d00p44/freqcount/freqcount_v2.0/readme.txt

v1.0
-Cs am Quarz falsch angebunden 
-kein ISP-Stecker
-----------------------------------------------------
v1.1
-Letzte Teilerstufe ergänzen 7->15 / 13->Dip-Schalter (1Hz Pulse)
-Status LED für Betriebs und Gatezustand ergänzen

Planung v2.0: -zusätzlicher 32-Bit-Zähler für Reziprokzählverfahren
	 		 -Gateöffner für beide Zähler
			 -ESP kompatibel mit MCP23017 (LP kompatibel mit ESPboy)
			 -Koax-SV für Messsignal
			 - Quarz-Adapter oder Abracon für Referenz

evtl. Netzteil und Batteriehalterung ergänzen
