d00p44/freqcount/freqcount_v2.0/out/freqcount1.1.pdf

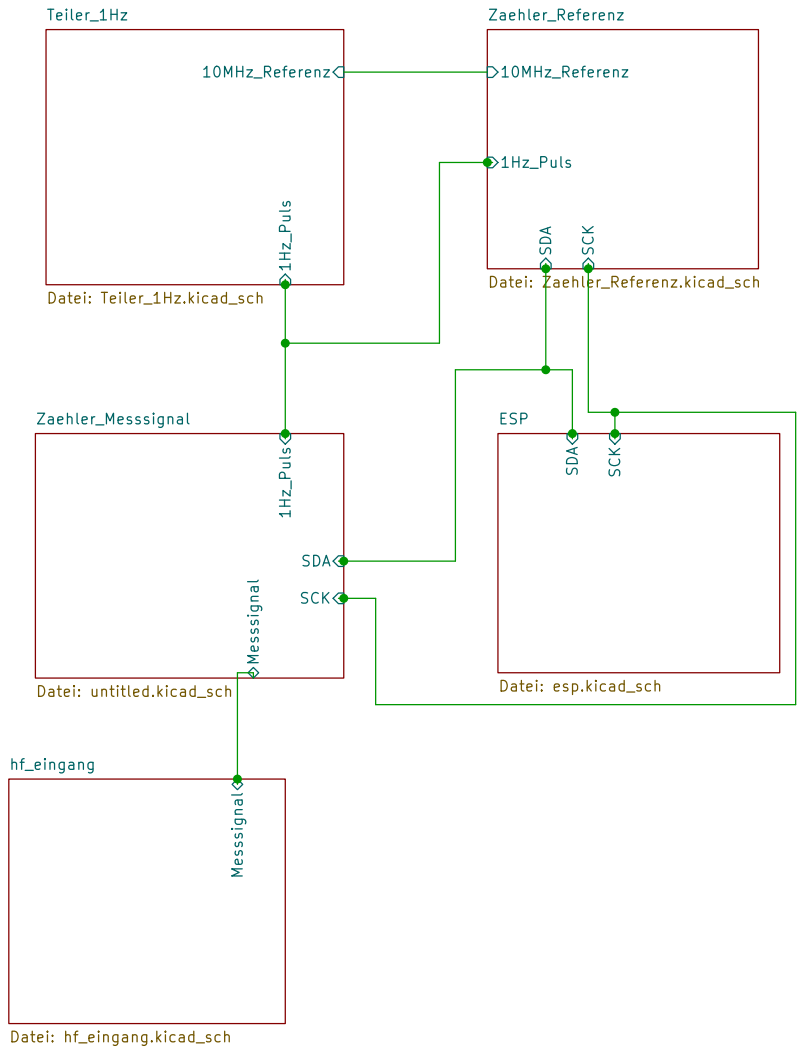
[picture p1: page 1]

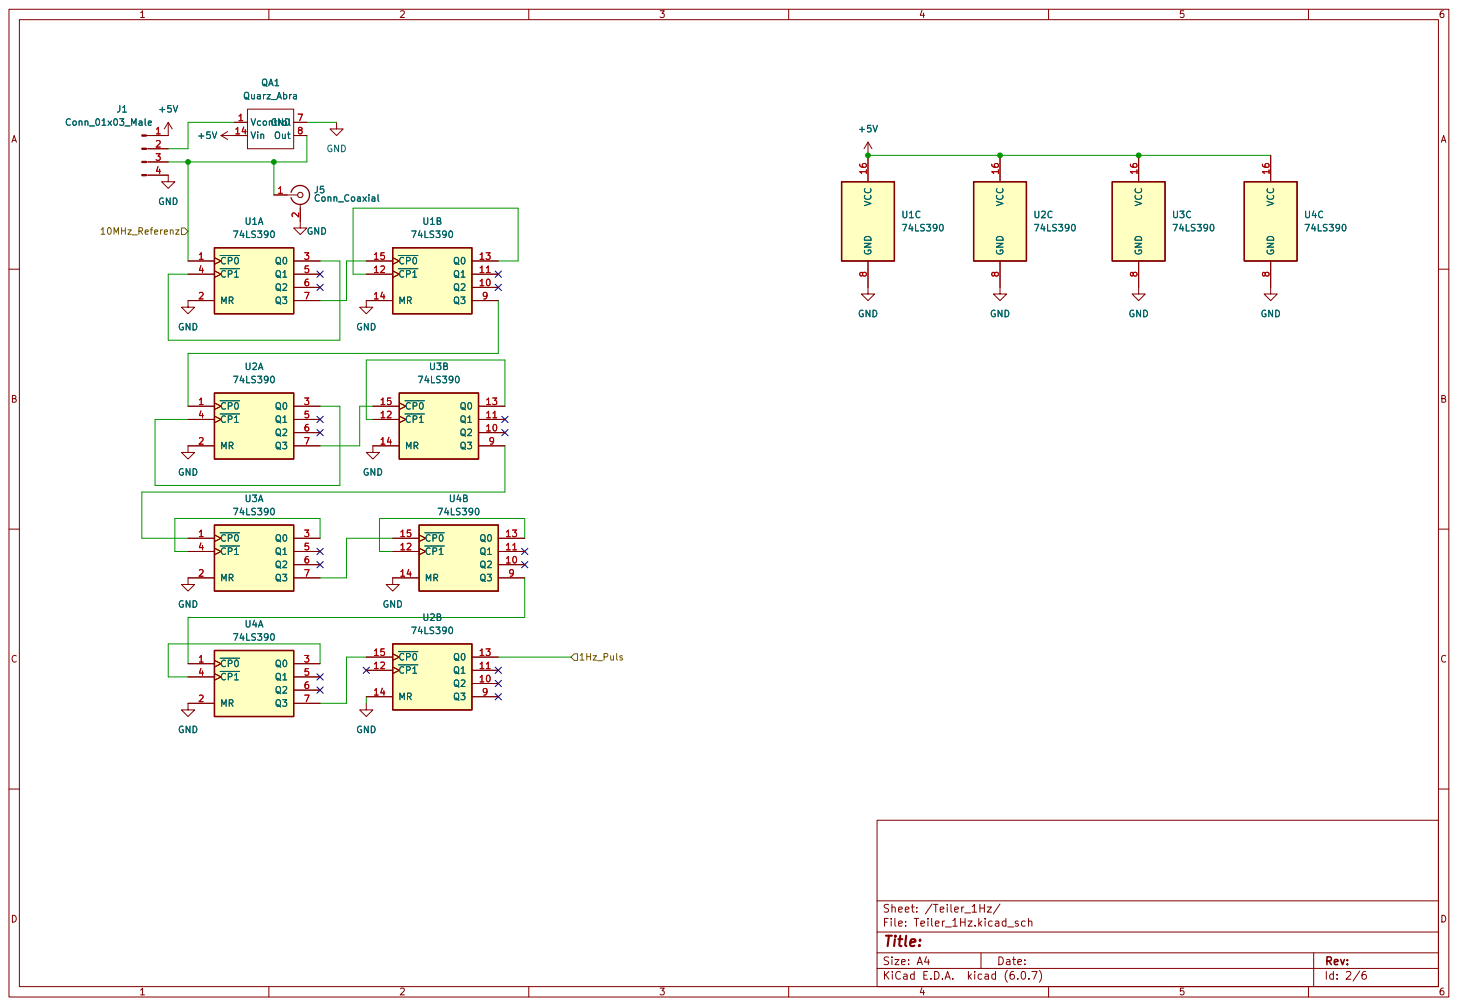
[picture p2: page 2]

2 +5V QA1 Quarz_Abra Vcontrol 1 Vin 14 GND 7 Out 8 U2A

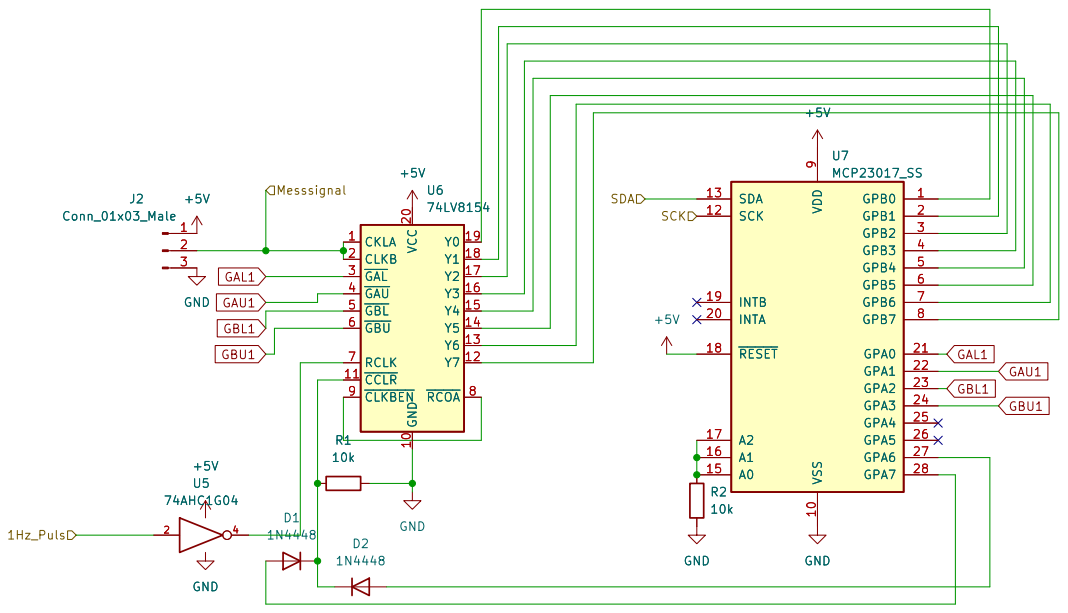
[picture p3: page 3]

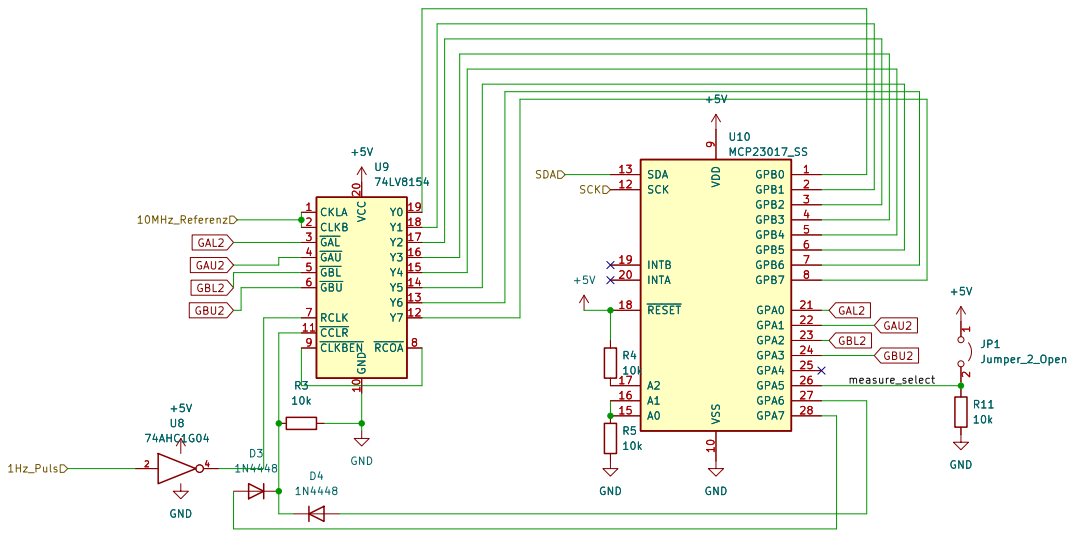
[picture p4: page 4]

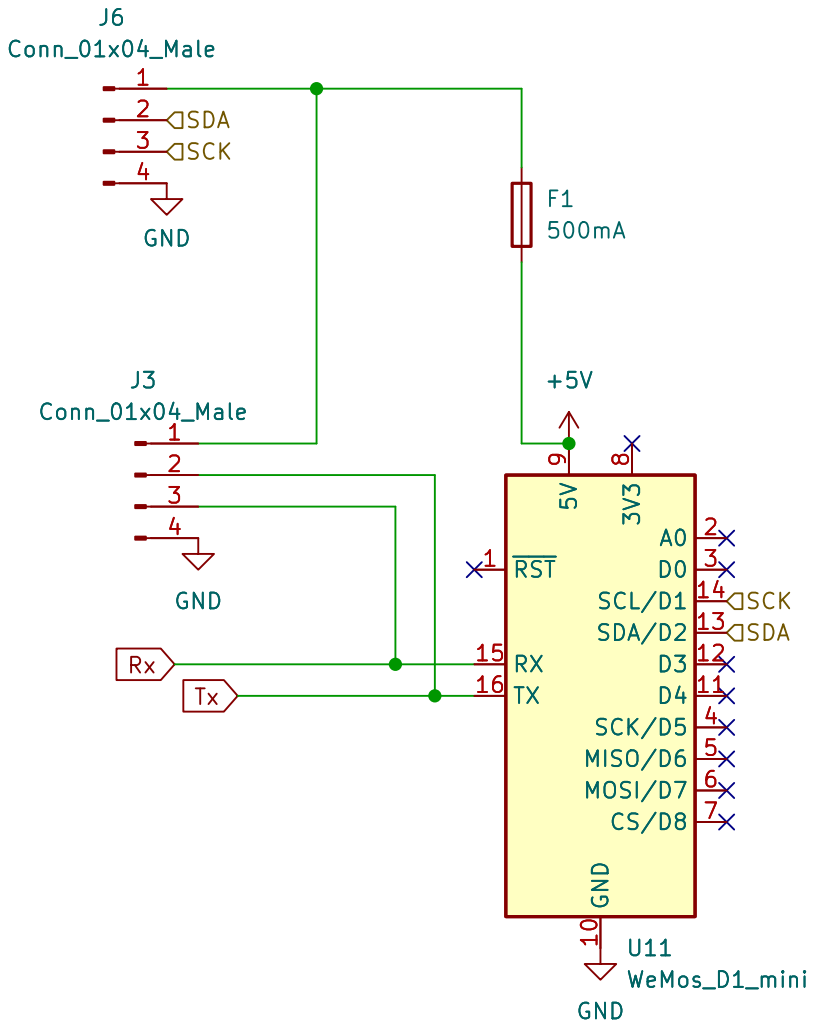
[picture p5: page 5]

File: esp.kicad_sch Sheet: /ESP/

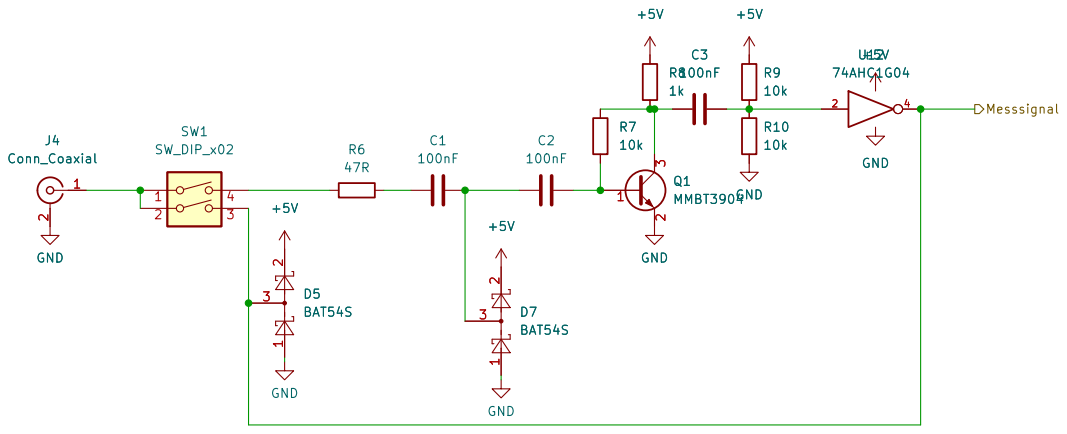
[picture p6: page 6]
