d00p44/freqcount/freqcount_v2.0/out/best.pdf

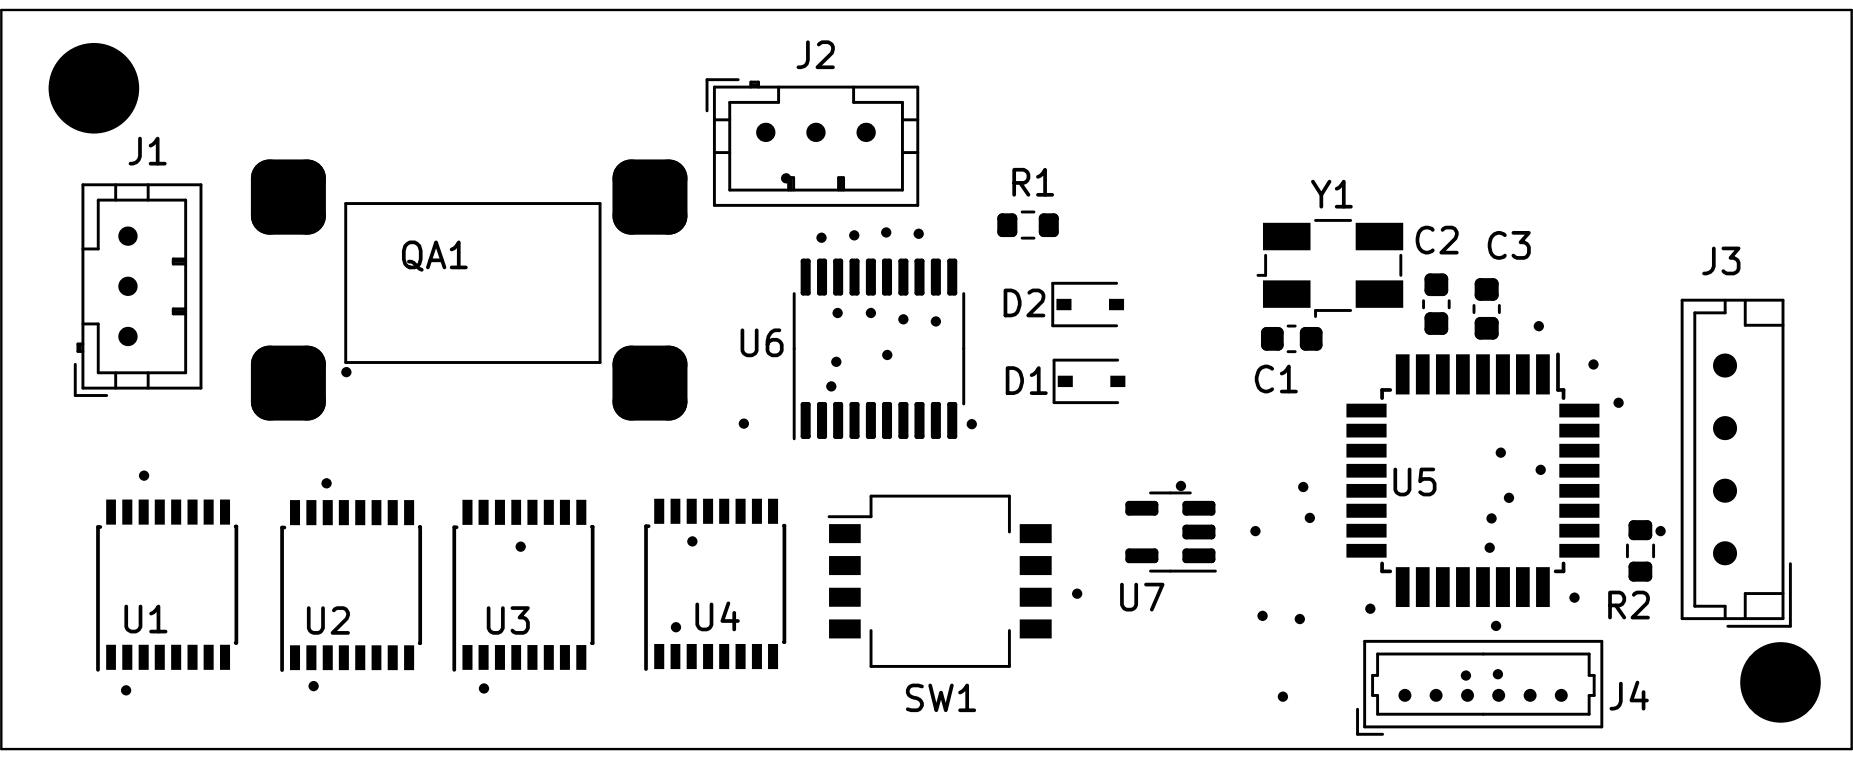
[picture p7: page 1]
