d00p44/freqcount/freqcount_v1.1/out/freqcount1.1.pdf

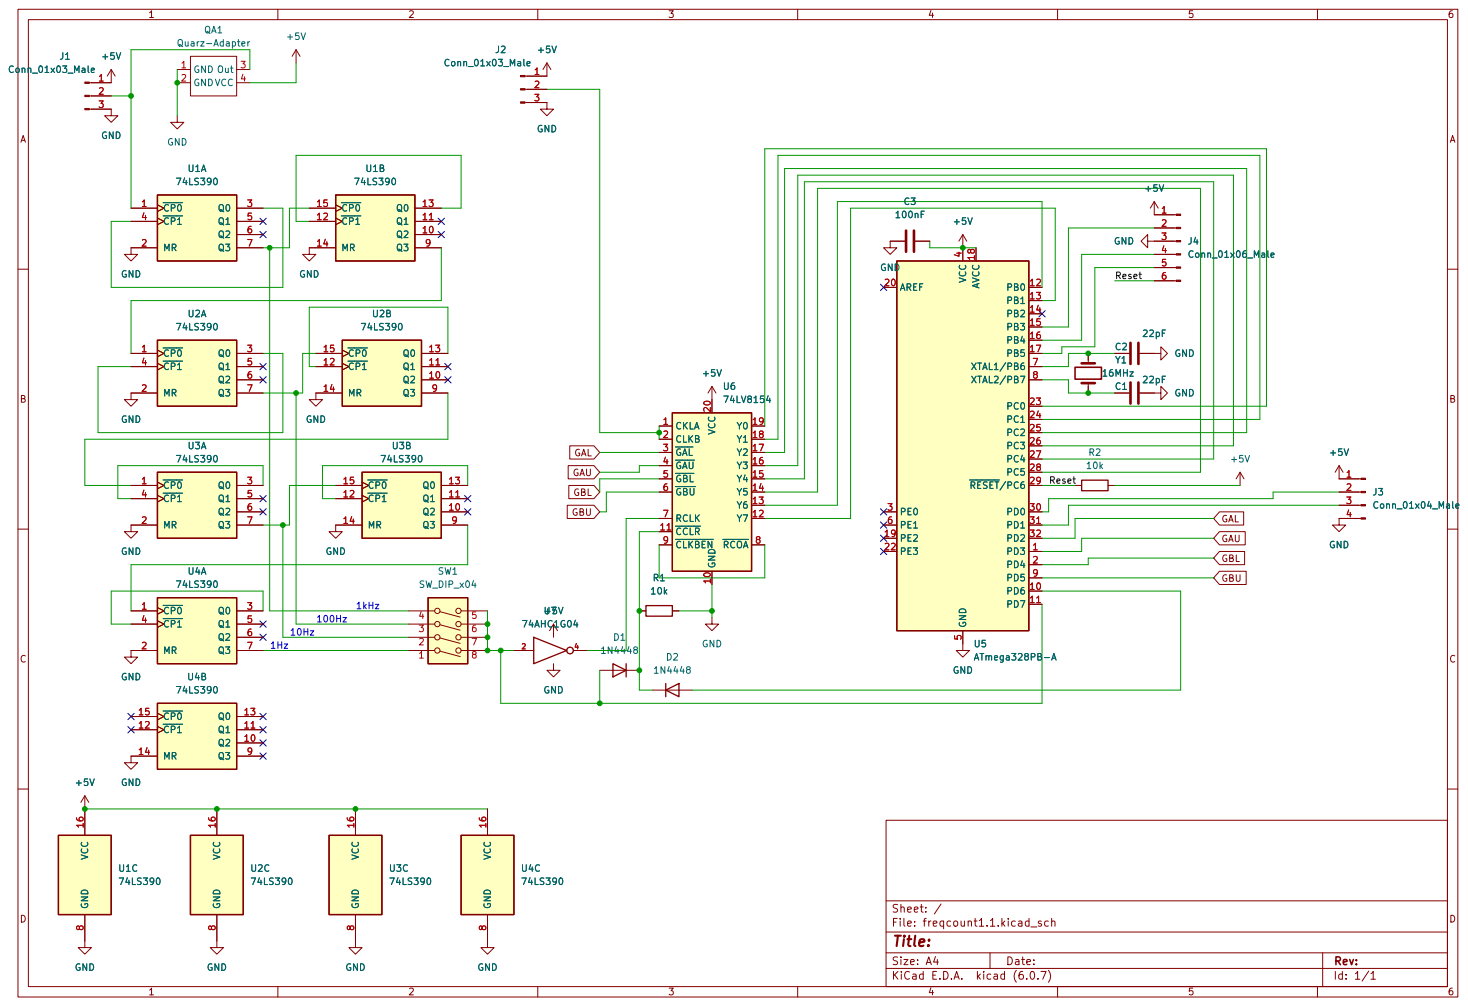
[picture p8: page 1]
