d00p44/freqcount/freqcount_v2.0/hf_eingang.asc

A1: inv; td=10n Vhigh=3.3
C1: cap; 100nF
C2: cap; 100nF
C3: cap; 100nF
D1: zener
D2: zener
Q1: npn; DI_MMBT3904
R1: res; 47
R2: res; 10k
R3: res; 1k
R4: res; 10k
R5: res; 10k
V1: voltage; 5
V2: voltage; SINE(0 0.8 4Meg)
Named nets: 0, Vcc, Out
.tran 1u
