d00p44/freqcount/freqcount_v2.0/freqcount1.1.kicad_pcb

## KiCad design freqcount_v2.0/freqcount1.1.kicad_pcb (2023-10-13)

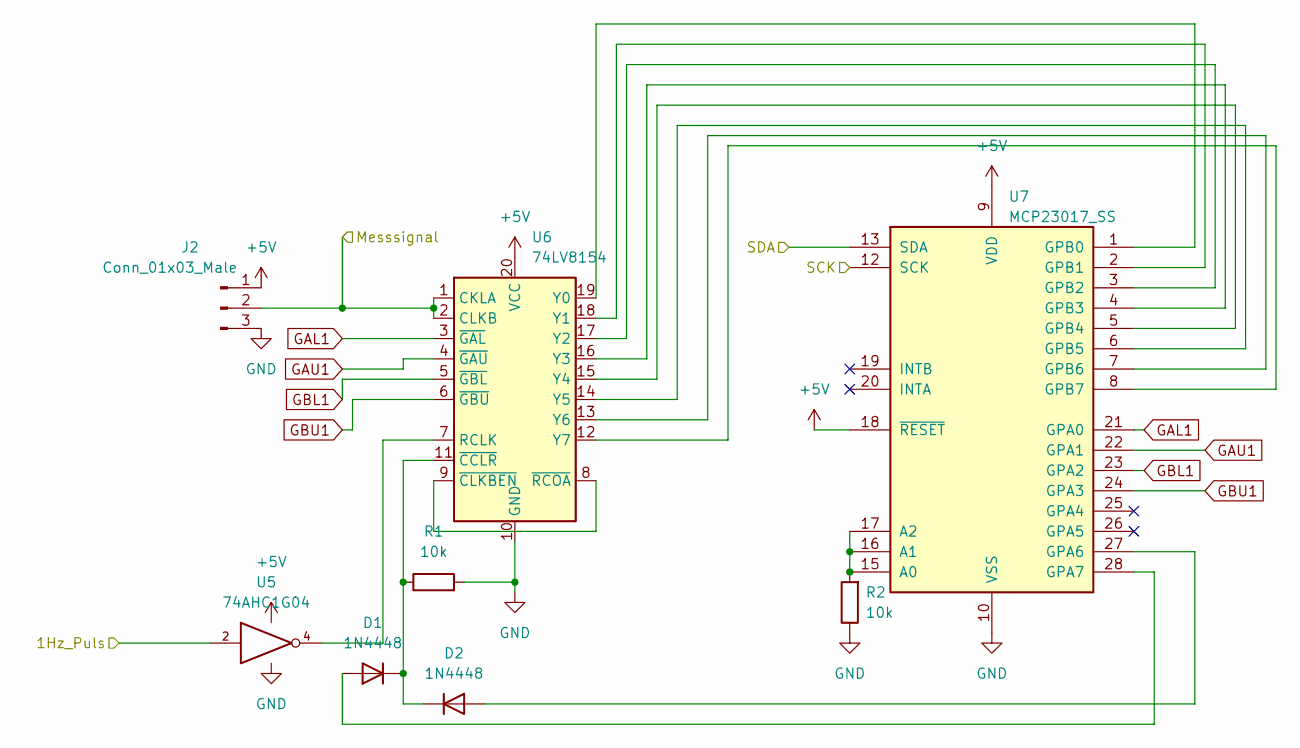
[picture p9: schematic untitled.kicad_sch]

Parts:
D1, D2: 1N4448; D_SOD-323
J2: Conn_01x03_Male; JST_PH_B3B-PH-K_1x03_P2.00mm_Vertical
R1, R2: 10k; R_0603_1608Metric
U5: 74AHC1G04; SOT-23-5
U6: 74LV8154; TSSOP-20_4.4x6.5mm_P0.65mm
U7: MCP23017_SS; SSOP-28_5.3x10.2mm_P0.65mm

Connections:
+5V: J2.1, U5.5 (VCC), U6.20 (VCC), U7.9 (VDD), U7.18 (~RESET); also elsewhere on the board
/ESP/SCK: U7.12 (SCK); also elsewhere on the board
/ESP/SDA: U7.13 (SDA); also elsewhere on the board
/Teiler_1Hz/1Hz_Puls: U5.2; also elsewhere on the board
/Zaehler_Messsignal/Messsignal: J2.2, U6.1 (CKLA), U6.2 (CLKB); also elsewhere on the board
GAL1: U6.3 (~GAL), U7.21 (GPA0)
GAU1: U6.4 (~GAU), U7.22 (GPA1)
GBL1: U6.5 (~GBL), U7.23 (GPA2)
GBU1: U6.6 (~GBU), U7.24 (GPA3)
GND: J2.3, R1.2, R2.1, U5.3 (GND), U6.10 (GND), U7.10 (VSS); also elsewhere on the board
unnamed: D1.1 (K), D2.1 (K), R1.1, U6.11 (~CCLR)
unnamed: D1.2 (A), U7.28 (GPA7)
unnamed: D2.2 (A), U7.27 (GPA6)
unnamed: R2.2, U7.15 (A0), U7.16 (A1), U7.17 (A2)
unnamed: U5.4, U6.7 (RCLK)
unnamed: U6.8 (~RCOA), U6.9 (~CLKBEN)
unnamed: U6.12 (Y7), U7.8 (GPB7)
unnamed: U6.13 (Y6), U7.7 (GPB6)
unnamed: U6.14 (Y5), U7.6 (GPB5)
unnamed: U6.15 (Y4), U7.5 (GPB4)
unnamed: U6.16 (Y3), U7.4 (GPB3)
unnamed: U6.17 (Y2), U7.3 (GPB2)
unnamed: U6.18 (Y1), U7.2 (GPB1)
unnamed: U6.19 (Y0), U7.1 (GPB0)

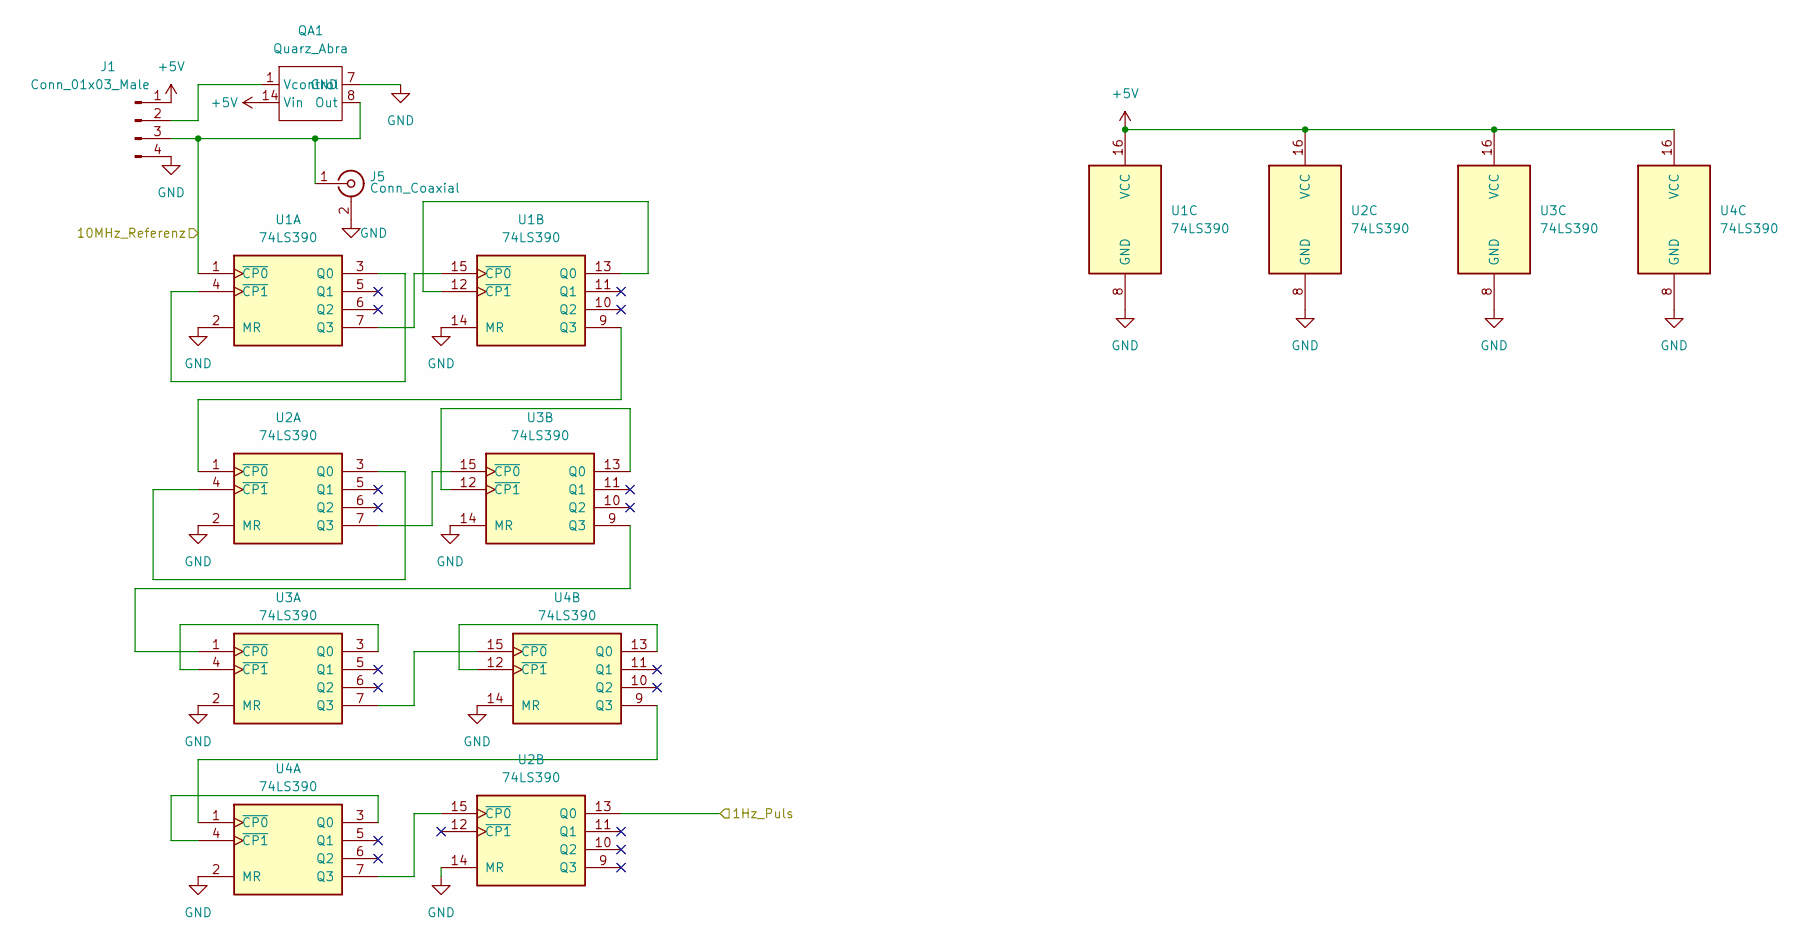
[picture p10: schematic Teiler_1Hz.kicad_sch]

Parts:
J1: Conn_01x03_Male; JST_PH_B4B-PH-K_1x04_P2.00mm_Vertical
J5: Conn_Coaxial; SMA_Amphenol_901-144_Vertical
QA1: Quarz_Abra; Quarz-Abra
U1, U2, U3, U4: 74LS390; SSOP-16_4.4x5.2mm_P0.65mm

Connections:
+5V: J1.1, QA1.14 (Vin), U1.16 (VCC), U2.16 (VCC), U3.16 (VCC), U4.16 (VCC); also elsewhere on the board
/Teiler_1Hz/1Hz_Puls: U2.13 (Q0); also elsewhere on the board
/Teiler_1Hz/10MHz_Referenz: J1.3, J5.1 (In), QA1.8 (Out), U1.1 (~CP0); also elsewhere on the board
GND: J1.4, J5.2 (Ext), QA1.7 (GND), U1.2 (MR), U1.8 (GND), U1.14 (MR), U2.2 (MR), U2.8 (GND), U2.14 (MR), U3.2 (MR), U3.8 (GND), U3.14 (MR), U4.2 (MR), U4.8 (GND), U4.14 (MR); also elsewhere on the board
unnamed: J1.2, QA1.1 (Vcontrol)
unnamed: U1.3 (Q0), U1.4 (~CP1)
unnamed: U1.9 (Q3), U2.1 (~CP0)
unnamed: U1.12 (~CP1), U1.13 (Q0)
unnamed: U1.7 (Q3), U1.15 (~CP0)
unnamed: U2.3 (Q0), U2.4 (~CP1)
unnamed: U2.7 (Q3), U3.15 (~CP0)
unnamed: U2.15 (~CP0), U4.7 (Q3)
unnamed: U3.1 (~CP0), U3.9 (Q3)
unnamed: U3.3 (Q0), U3.4 (~CP1)
unnamed: U3.7 (Q3), U4.15 (~CP0)
unnamed: U3.12 (~CP1), U3.13 (Q0)
unnamed: U4.1 (~CP0), U4.9 (Q3)
unnamed: U4.3 (Q0), U4.4 (~CP1)
unnamed: U4.12 (~CP1), U4.13 (Q0)

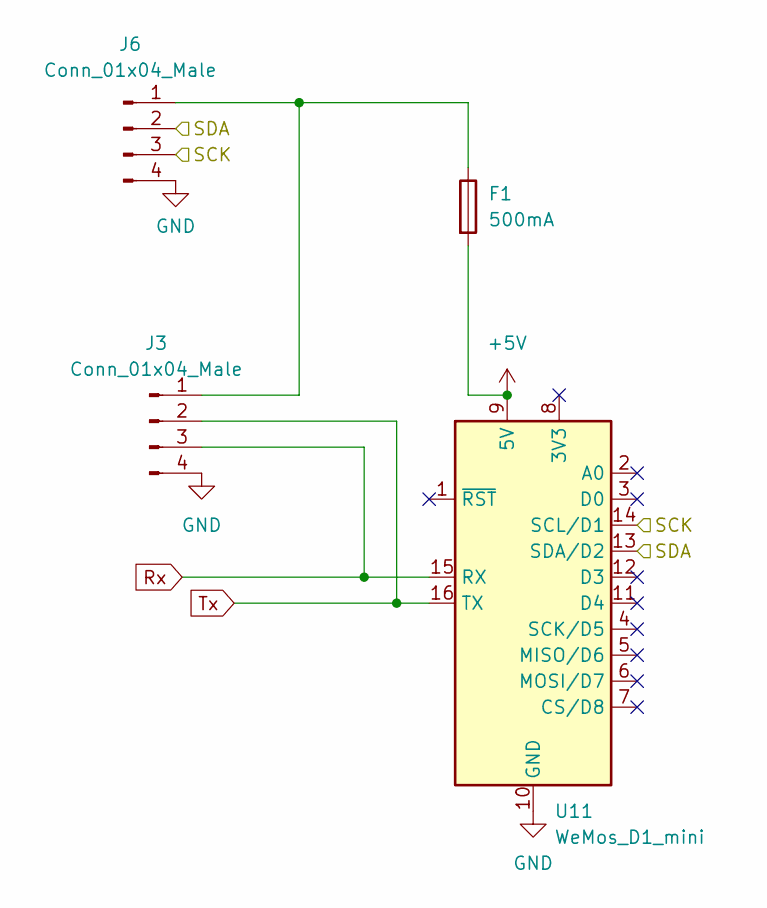
[picture p11: schematic esp.kicad_sch]

Parts:
F1: 500mA; Fuseholder_TR5_Littelfuse_No560_No460
J3, J6: Conn_01x04_Male; JST_PH_B4B-PH-K_1x04_P2.00mm_Vertical
U11: WeMos_D1_mini; WEMOS_D1_mini_light

Connections:
+5V: F1.2, U11.9 (5V); also elsewhere on the board
/ESP/SCK: J6.3, U11.14 (SCL/D1); also elsewhere on the board
/ESP/SDA: J6.2, U11.13 (SDA/D2); also elsewhere on the board
GND: J3.4, J6.4, U11.10 (GND); also elsewhere on the board
unnamed: F1.1, J3.1, J6.1
Rx: J3.3, U11.15 (RX)
Tx: J3.2, U11.16 (TX)

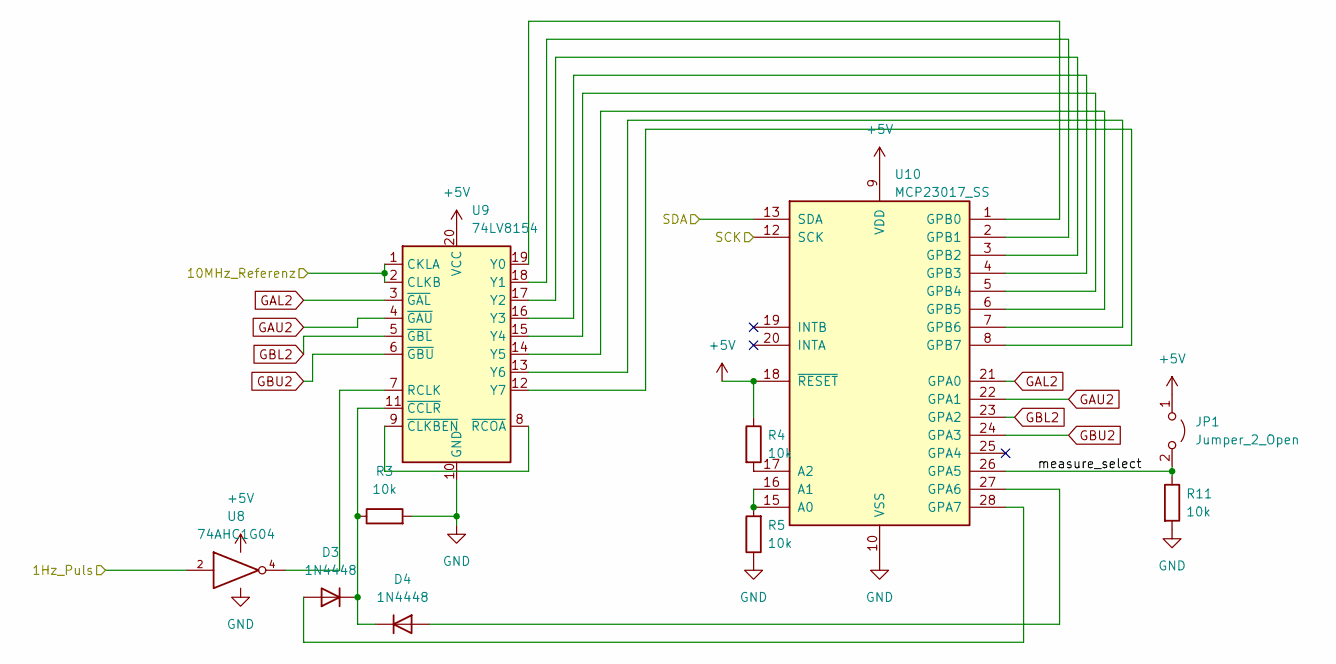
[picture p12: schematic Zaehler_Referenz.kicad_sch]

Parts:
D3, D4: 1N4448; D_SOD-323
JP1: Jumper_2_Open; PinHeader_1x02_P2.54mm_Vertical
R3, R4, R5, R11: 10k; R_0603_1608Metric
U8: 74AHC1G04; SOT-23-5
U9: 74LV8154; TSSOP-20_4.4x6.5mm_P0.65mm
U10: MCP23017_SS; SSOP-28_5.3x10.2mm_P0.65mm

Connections:
+5V: JP1.1 (A), R4.1, U8.5 (VCC), U9.20 (VCC), U10.9 (VDD), U10.18 (~RESET); also elsewhere on the board
/ESP/SCK: U10.12 (SCK); also elsewhere on the board
/ESP/SDA: U10.13 (SDA); also elsewhere on the board
/Teiler_1Hz/1Hz_Puls: U8.2; also elsewhere on the board
/Teiler_1Hz/10MHz_Referenz: U9.1 (CKLA), U9.2 (CLKB); also elsewhere on the board
/Zaehler_Referenz/measure_select: JP1.2 (B), R11.1, U10.26 (GPA5)
GAL2: U9.3 (~GAL), U10.21 (GPA0)
GAU2: U9.4 (~GAU), U10.22 (GPA1)
GBL2: U9.5 (~GBL), U10.23 (GPA2)
GBU2: U9.6 (~GBU), U10.24 (GPA3)
GND: R3.2, R5.1, R11.2, U8.3 (GND), U9.10 (GND), U10.10 (VSS); also elsewhere on the board
unnamed: D3.1 (K), D4.1 (K), R3.1, U9.11 (~CCLR)
unnamed: D3.2 (A), U10.28 (GPA7)
unnamed: D4.2 (A), U10.27 (GPA6)
unnamed: R4.2, U10.17 (A2)
unnamed: R5.2, U10.15 (A0), U10.16 (A1)
unnamed: U8.4, U9.7 (RCLK)
unnamed: U9.8 (~RCOA), U9.9 (~CLKBEN)
unnamed: U9.19 (Y0), U10.1 (GPB0)
unnamed: U9.18 (Y1), U10.2 (GPB1)
unnamed: U9.17 (Y2), U10.3 (GPB2)
unnamed: U9.16 (Y3), U10.4 (GPB3)
unnamed: U9.15 (Y4), U10.5 (GPB4)
unnamed: U9.14 (Y5), U10.6 (GPB5)
unnamed: U9.13 (Y6), U10.7 (GPB6)
unnamed: U9.12 (Y7), U10.8 (GPB7)

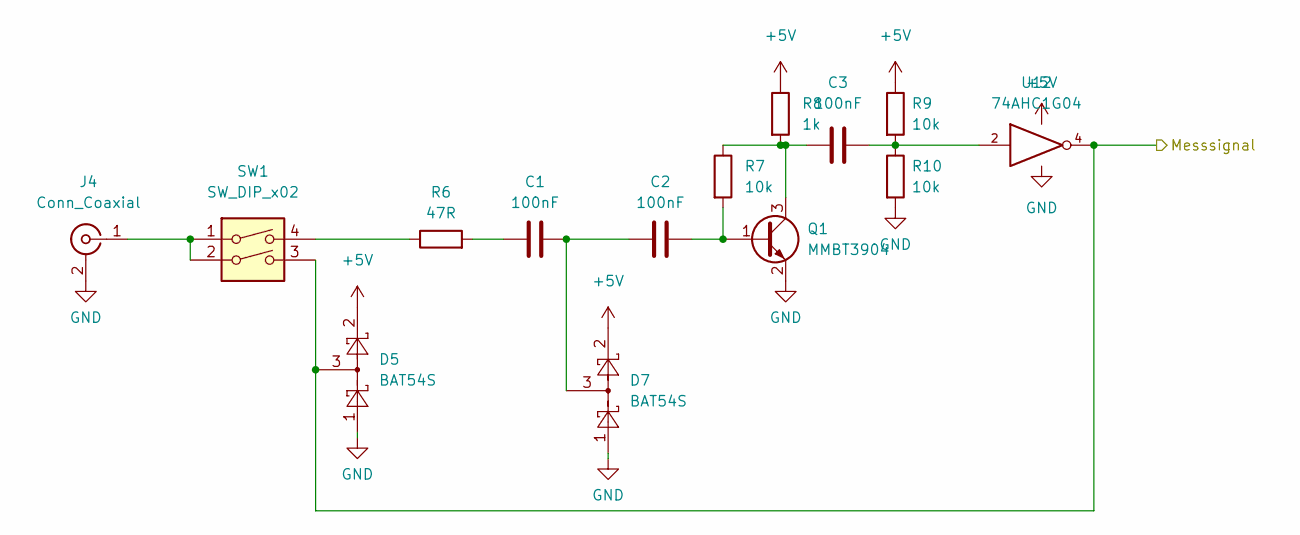
[picture p13: schematic hf_eingang.kicad_sch]

Parts:
C1, C2, C3: 100nF; C_0603_1608Metric
D5, D7: BAT54S; SOT-23
J4: Conn_Coaxial; SMA_Amphenol_901-144_Vertical
Q1: MMBT3904; SOT-23
R6: 47R; R_0603_1608Metric
R7, R9, R10: 10k; R_0603_1608Metric
R8: 1k; R_0603_1608Metric
SW1: SW_DIP_x02; DIP-4_W8.89mm_SMDSocket_LongPads
U12: 74AHC1G04; SOT-23-5

Connections:
+5V: D5.2, D7.2, R8.1, R9.1, U12.5 (VCC); also elsewhere on the board
/Zaehler_Messsignal/Messsignal: D5.3, SW1.3, U12.4; also elsewhere on the board
GND: D5.1, D7.1, J4.2 (Ext), Q1.2 (E), R10.2, U12.3 (GND); also elsewhere on the board
unnamed: C1.1, R6.2
unnamed: C1.2, C2.1, D7.3
unnamed: C2.2, Q1.1 (B), R7.2
unnamed: C3.1, Q1.3 (C), R7.1, R8.2
unnamed: C3.2, R9.2, R10.1, U12.2
unnamed: J4.1 (In), SW1.1, SW1.2
unnamed: R6.1, SW1.4

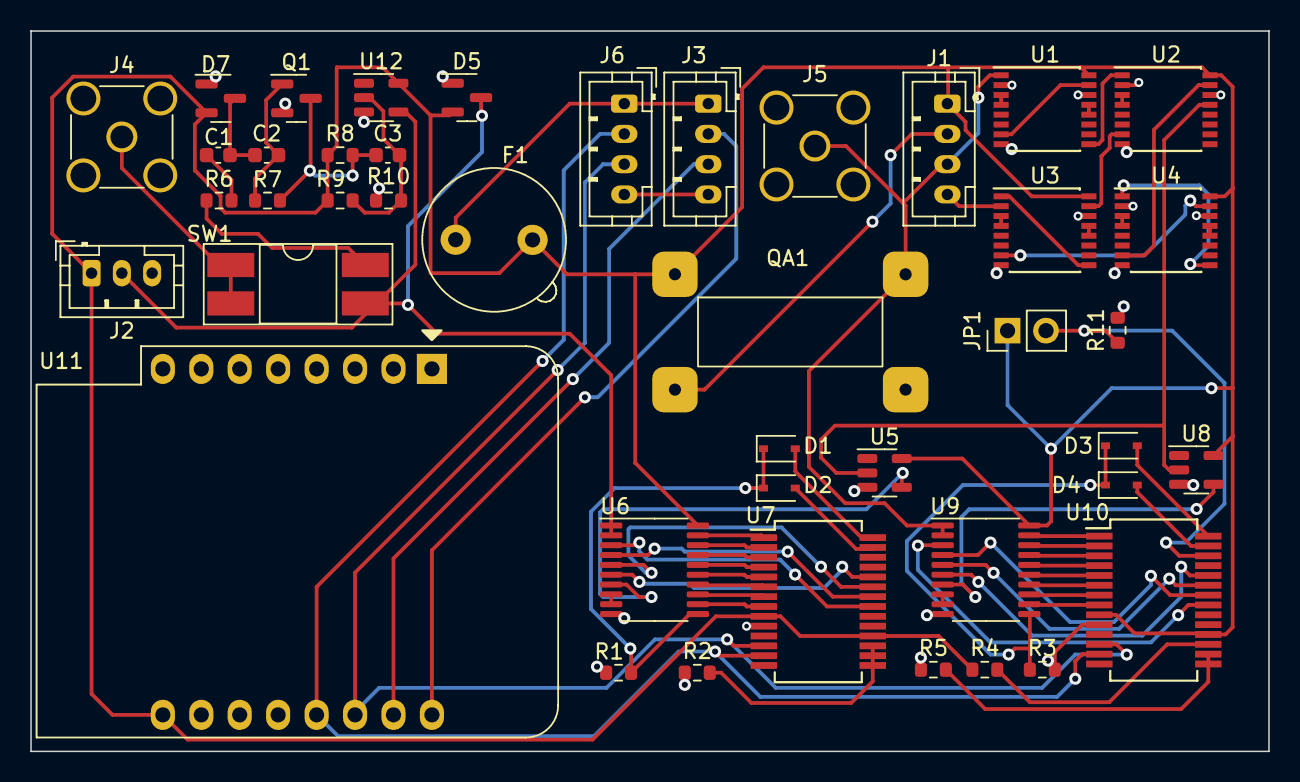
[picture p14: board freqcount1.1.kicad_pcb from above]

Board: 2 copper layers, 81.8 x 47.6 mm, 43 parts (0 on the bottom side), 70 nets.
