d00p44/freqcount/freqcount_v1/freqcount.kicad_pcb

## KiCad design freqcount_v1/freqcount.kicad_pcb (2023-06-28, an earlier design)

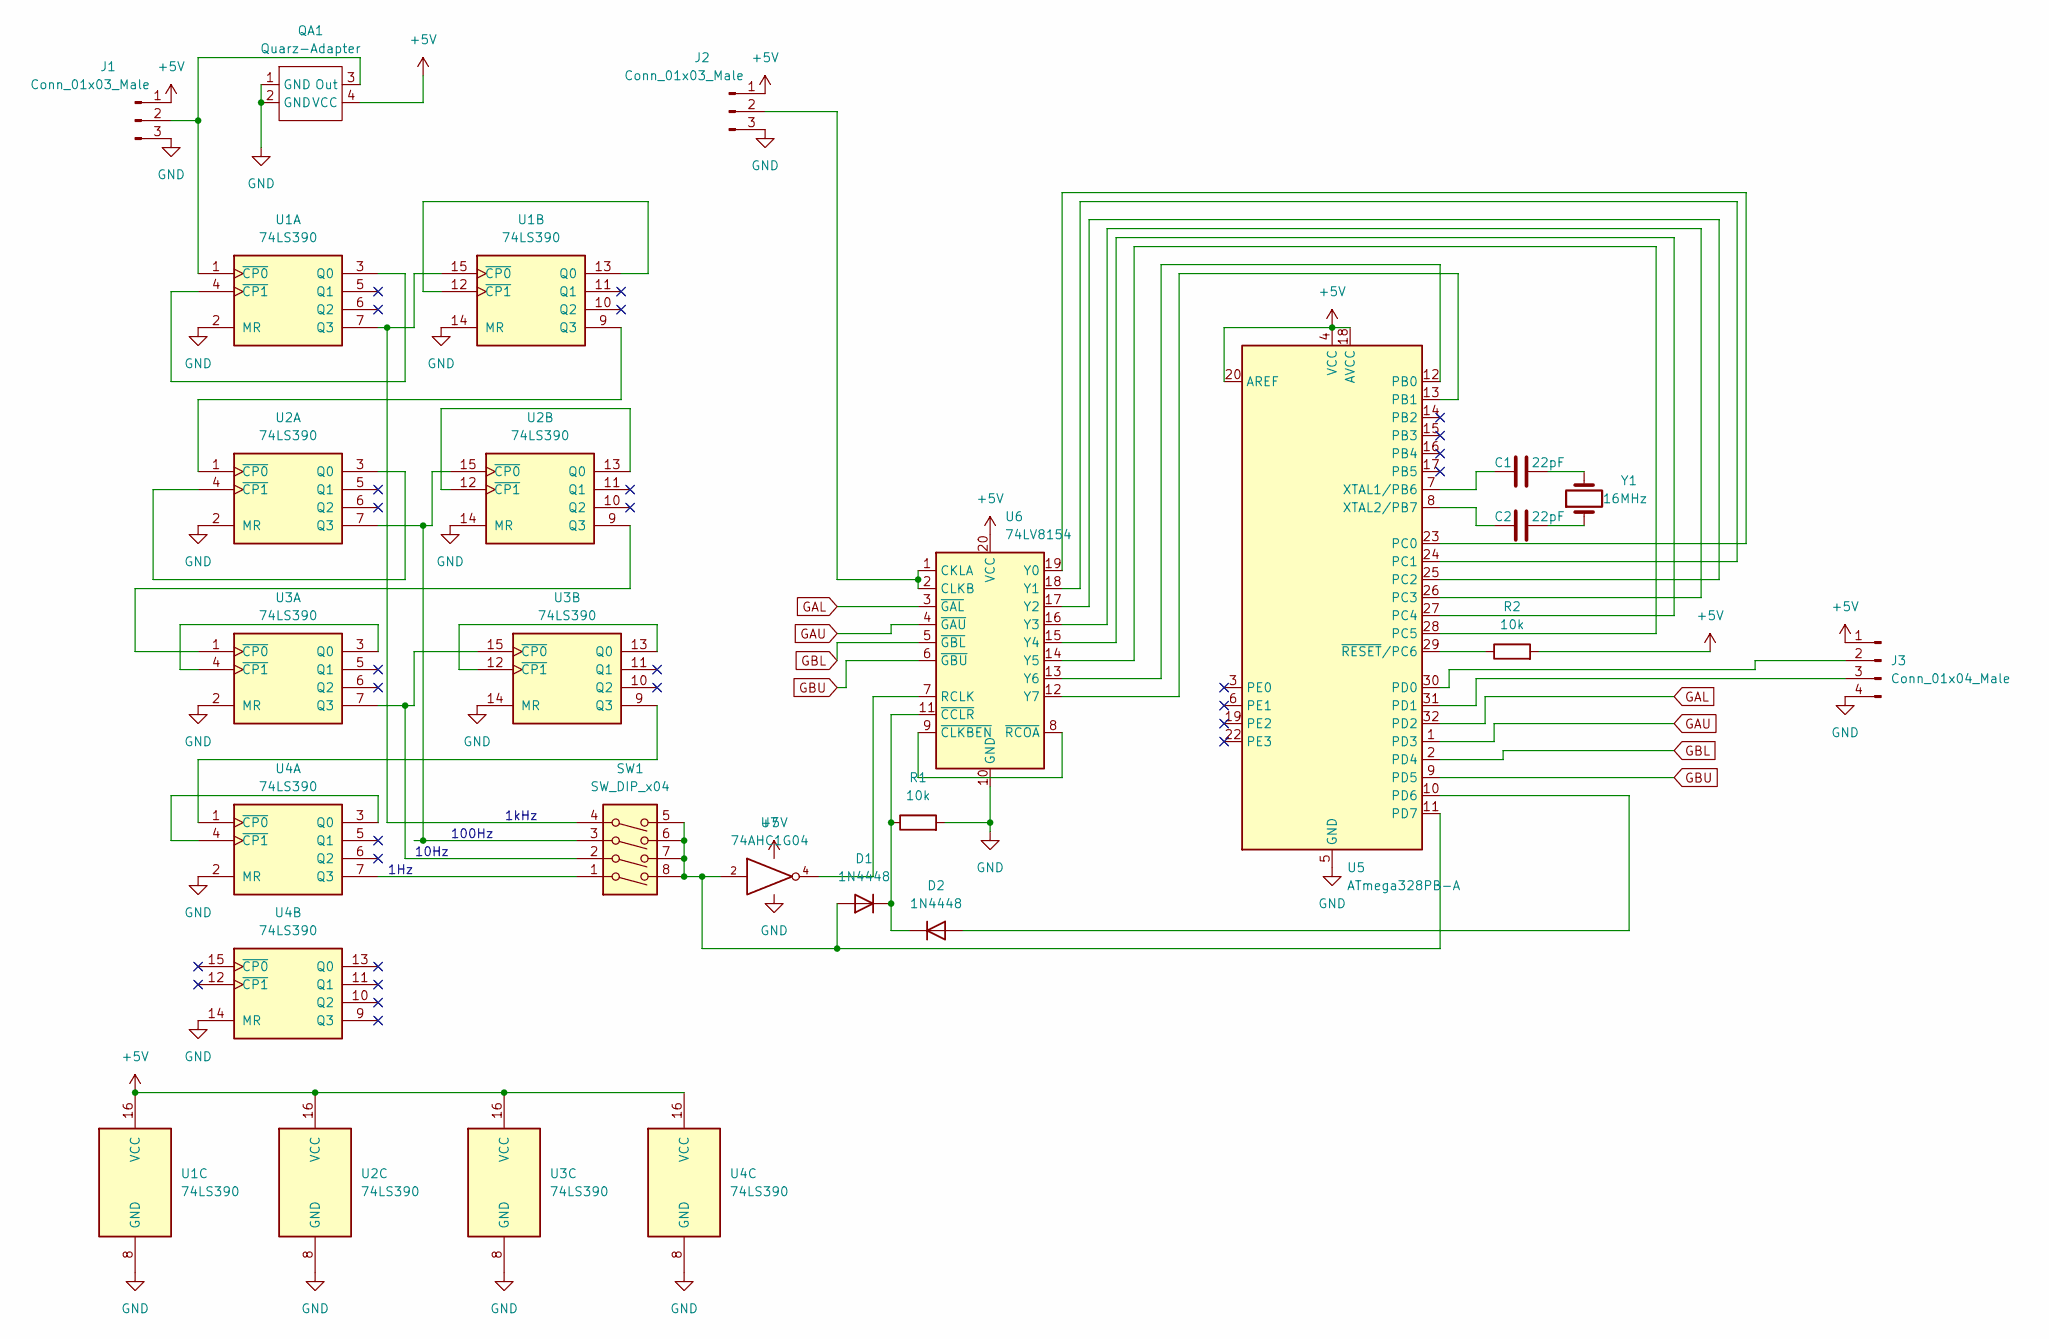
[picture p15: schematic freqcount.kicad_sch]

Parts:
C1, C2: 22pF; C_0603_1608Metric
D1, D2: 1N4448; D_SOD-323
J1, J2: Conn_01x03_Male; JST_PH_B3B-PH-K_1x03_P2.00mm_Vertical
J3: Conn_01x04_Male; JST_EH_B4B-EH-A_1x04_P2.50mm_Vertical
QA1: Quarz-Adapter
R1, R2: 10k; R_0603_1608Metric
SW1: SW_DIP_x04; SW_DIP_SPSTx04_Slide_KingTek_DSHP04TS_W7.62mm_P1.27mm
U1, U2, U3, U4: 74LS390; SSOP-16_4.4x5.2mm_P0.65mm
U5: ATmega328PB-A; TQFP-32_7x7mm_P0.8mm
U6: 74LV8154; TSSOP-20_4.4x6.5mm_P0.65mm
U7: 74AHC1G04; SOT-23-5
Y1: 16MHz; Crystal_SMD_EuroQuartz_MJ-4Pin_5.0x3.2mm

Connections:
+5V: J1.1, J2.1, J3.1, QA1.4 (VCC), R2.2, U1.16 (VCC), U2.16 (VCC), U3.16 (VCC), U4.16 (VCC), U5.4 (VCC), U5.18 (AVCC), U5.20 (AREF), U6.20 (VCC), U7.5 (VCC)
GAL: U5.32 (PD2), U6.3 (~GAL)
GAU: U5.1 (PD3), U6.4 (~GAU)
GBL: U5.2 (PD4), U6.5 (~GBL)
GBU: U5.9 (PD5), U6.6 (~GBU)
GND: J1.3, J2.3, J3.4, QA1.1 (GND), QA1.2 (GND), R1.2, U1.2 (MR), U1.8 (GND), U1.14 (MR), U2.2 (MR), U2.8 (GND), U2.14 (MR), U3.2 (MR), U3.8 (GND), U3.14 (MR), U4.2 (MR), U4.8 (GND), U4.14 (MR), U5.5 (GND), U5.21 (GND), U6.10 (GND), U7.3 (GND)
unnamed: C1.2, Y1.2
unnamed: C2.2, Y1.1
unnamed: D1.1 (K), D2.1 (K), R1.1, U6.11 (~CCLR)
unnamed: D2.2 (A), U5.10 (PD6)
unnamed: J1.2, QA1.3 (Out), U1.1 (~CP0)
unnamed: J2.2, U6.1 (CKLA), U6.2 (CLKB)
unnamed: R2.1, U5.29 (~RESET/PC6)
unnamed: SW1.3, U2.7 (Q3), U2.15 (~CP0)
unnamed: SW1.4, U1.7 (Q3), U1.15 (~CP0)
unnamed: U1.3 (Q0), U1.4 (~CP1)
unnamed: U1.12 (~CP1), U1.13 (Q0)
unnamed: U1.9 (Q3), U2.1 (~CP0)
unnamed: U2.3 (Q0), U2.4 (~CP1)
unnamed: U2.12 (~CP1), U2.13 (Q0)
unnamed: U2.9 (Q3), U3.1 (~CP0)
unnamed: U3.3 (Q0), U3.4 (~CP1)
unnamed: SW1.2, U3.7 (Q3), U3.15 (~CP0)
unnamed: U3.12 (~CP1), U3.13 (Q0)
unnamed: U3.9 (Q3), U4.1 (~CP0)
unnamed: U4.3 (Q0), U4.4 (~CP1)
unnamed: SW1.1, U4.7 (Q3)
unnamed: C1.1, U5.7 (XTAL1/PB6)
unnamed: C2.1, U5.8 (XTAL2/PB7)
unnamed: J3.2, U5.30 (PD0)
unnamed: J3.3, U5.31 (PD1)
unnamed: U6.7 (RCLK), U7.4
unnamed: U6.8 (~RCOA), U6.9 (~CLKBEN)
unnamed: U5.13 (PB1), U6.12 (Y7)
unnamed: U5.12 (PB0), U6.13 (Y6)
unnamed: U5.28 (PC5), U6.14 (Y5)
unnamed: U5.27 (PC4), U6.15 (Y4)
unnamed: U5.26 (PC3), U6.16 (Y3)
unnamed: U5.25 (PC2), U6.17 (Y2)
unnamed: U5.24 (PC1), U6.18 (Y1)
unnamed: U5.23 (PC0), U6.19 (Y0)
unnamed: D1.2 (A), SW1.5, SW1.6, SW1.7, SW1.8, U5.11 (PD7), U7.2

Notes on the sheet:
1kHz
100Hz
1Hz
10Hz

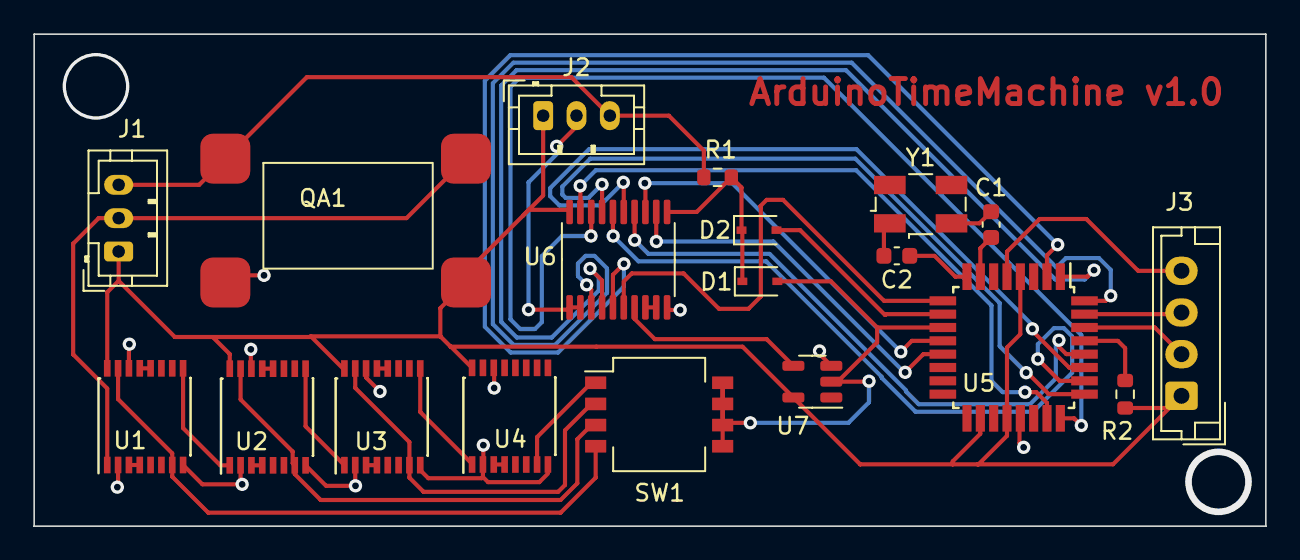
[picture p16: board freqcount.kicad_pcb from above]

Board: 2 copper layers, 73.9 x 29.5 mm, 19 parts (0 on the bottom side), 42 nets.
